PStreiffer/current-limiter-prototype/current_limiter.kicad_pcb

## KiCad design current_limiter.kicad_pcb (2026-08-11)

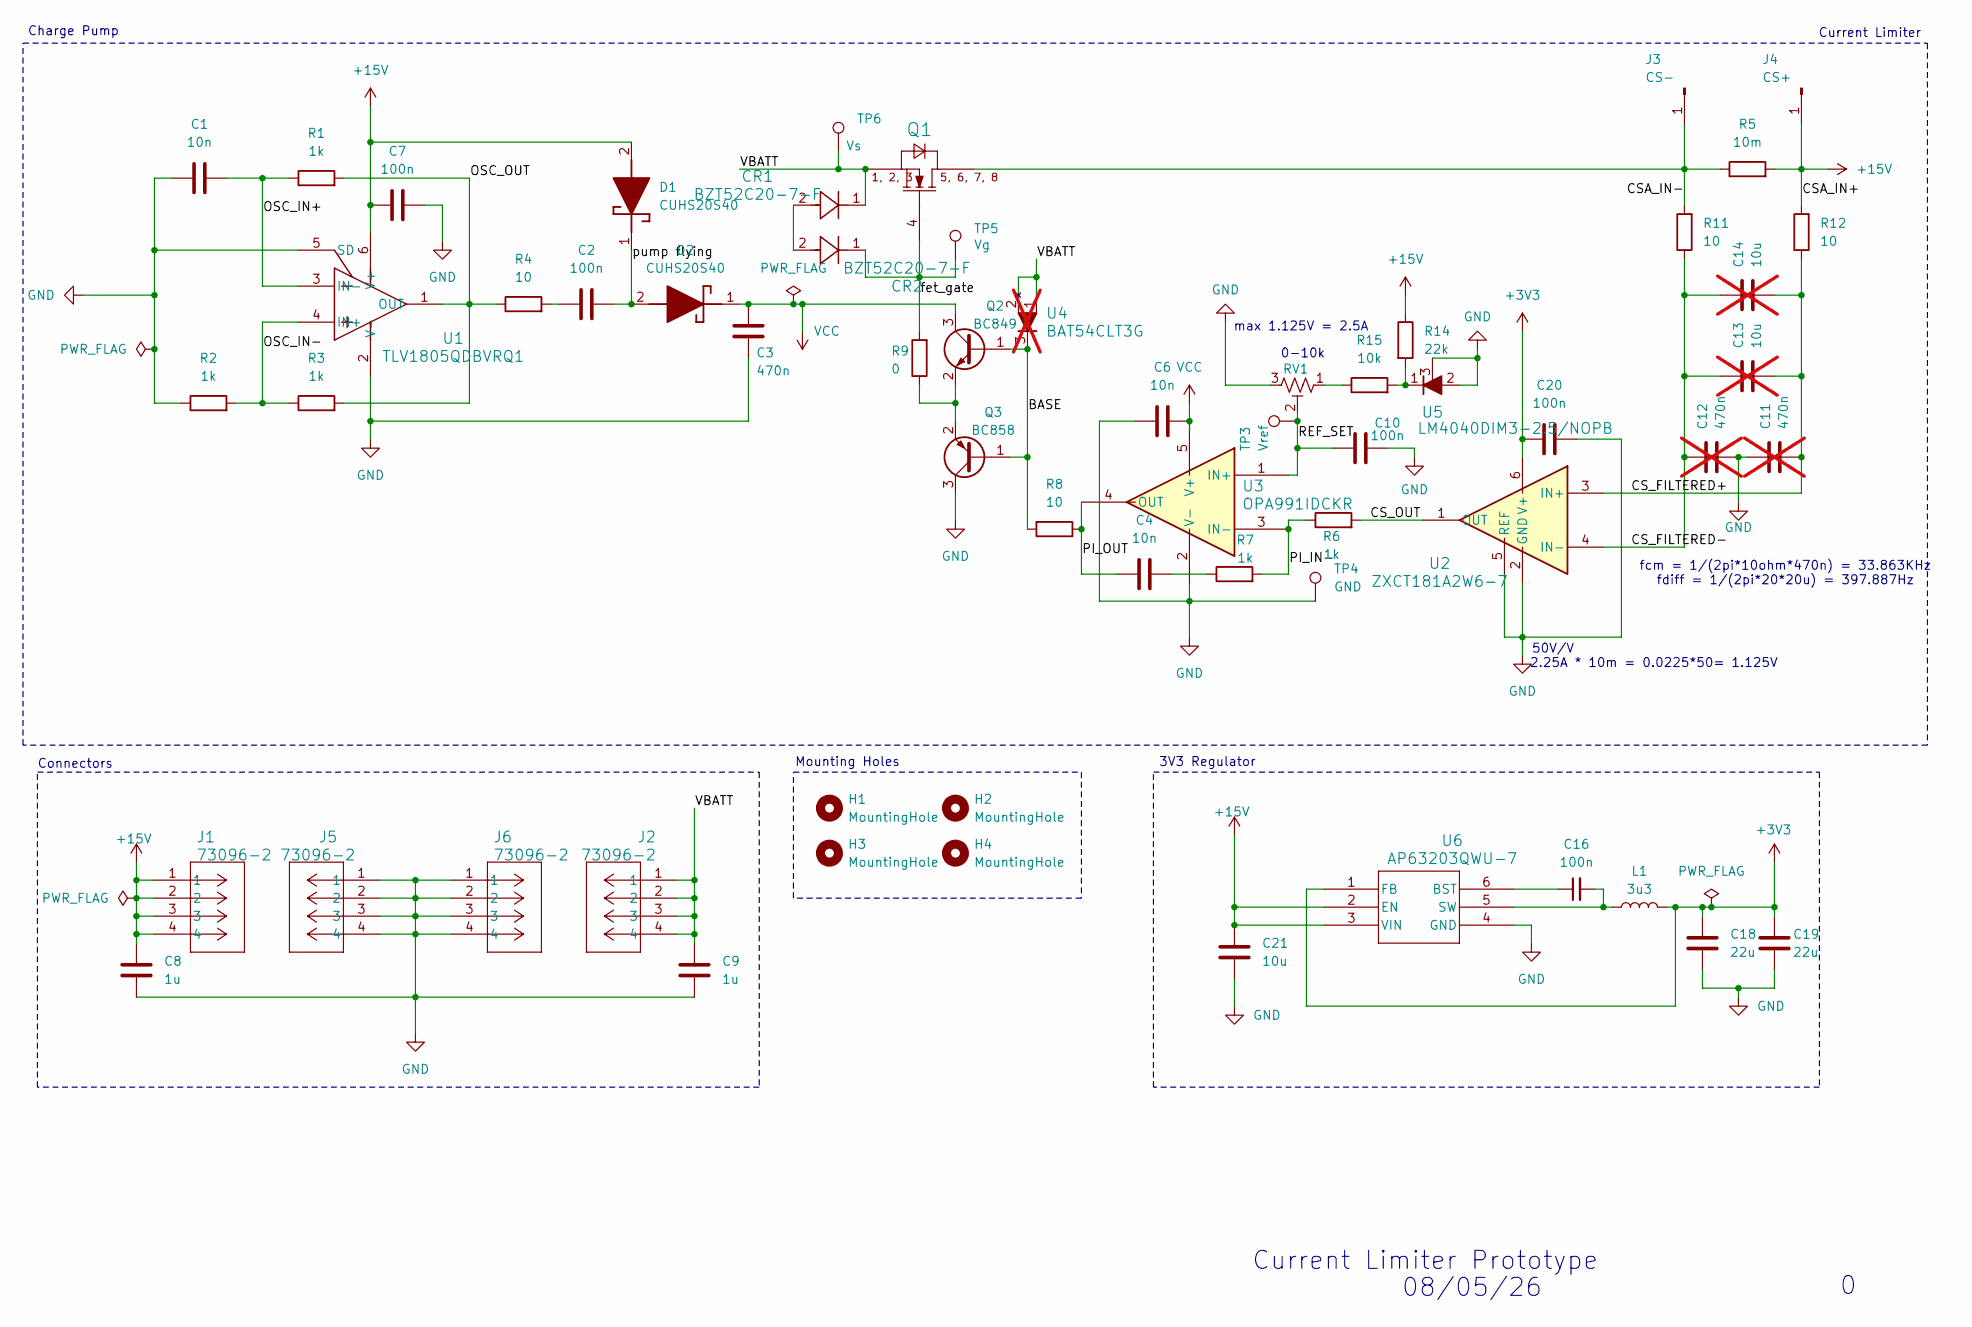
[picture p1: schematic current_limiter.kicad_sch]

Parts:
C1, C4, C6: 10n; C_0805_2012Metric
C2, C7, C10, C16, C20: 100n; C_0805_2012Metric
C3: 470n; C_0805_2012Metric
C8, C9: 1u; C_0805_2012Metric
C11, C12: 470n; C_0805_2012Metric; not fitted
C13, C14: 10u; C_0805_2012Metric; not fitted
C18, C19: 22u; C_0805_2012Metric
C21: 10u; C_0805_2012Metric
CR1, CR2: BZT52C20-7-F; SOD123_DIO
D1, D2: CUHS20S40; Manufacturer_Part_Number CUHS20S40
H1, H2, H3, H4: MountingHole; MountingHole_4.3mm_M4
J1, J2, J5, J6: 73096-2; CONN_73096-2_POM
J3: CS-; PinHeader_1x01_P1.27mm_Vertical
J4: CS+; PinHeader_1x01_P1.27mm_Vertical
L1: 3u3; IND_BOURNS_SDR0302
Q1: ISC025N08NM5LF2; INF-PG-TDSON-8-SSO8
Q2: BC849; SOT-23
Q3: BC858; SOT-23
R1, R2, R3, R6, R7: 1k; R_0805_2012Metric
R4, R8, R11, R12: 10; R_0805_2012Metric
R5: 10m; R_0805_2012Metric
R9: 0; R_0805_2012Metric
R14: 22k; R_0805_2012Metric
R15: 10k; R_0805_2012Metric
RV1: R_Potentiometer_Trim_US; Potentiometer_Runtron_RM-063_Horizontal
TP3: Vref; TestPoint_Pad_D2.0mm
TP4: GND; TestPoint_Pad_D2.0mm
TP5: Vg; TestPoint_Pad_D2.0mm
TP6: Vs; TestPoint_Pad_D2.0mm
U1: TLV1805QDBVRQ1; DBV0006A_L
U2: ZXCT181A2W6-7; DBV0006A_L
U3: OPA991IDCKR; SC_91IDCKR_TEX
U4: BAT54CLT3G; SOT-23-3_1P4X3P040_ONS; not fitted
U5: LM4040DIM3-2.5/NOPB; DBZ3
U6: AP63203QWU-7; TSOT26_DIO

Connections:
+3V3: C18.1, C19.1, C20.1, L1.2, U2.6 (V+), U6.1 (FB)
+15V: C7.1, C8.1, C21.1, D1.2 (A), J1.1, J1.2, J1.3, J1.4, J4.1 (Pin_1_1), R5.2, R12.2, R14.1, U1.6 (V+), U6.2 (EN), U6.3 (VIN)
/BASE: Q2.1 (B), Q3.1 (B), R8.2, U4.3
/CSA_IN-: J3.1 (Pin_1_1), Q1.5 (DRAIN), Q1.6 (DRAIN), Q1.7 (DRAIN), Q1.8 (DRAIN), R5.1, R11.2
/CS_FILTERED+: C11.1, C13.1, C14.1, R12.1, U2.3 (IN+)
/CS_FILTERED-: C12.2, C13.2, C14.2, R11.1, U2.4 (IN-)
/CS_OUT: R6.2, U2.1 (OUT)
/OSC_IN+: C1.2, R1.1, U1.3 (IN-)
/OSC_IN-: R2.2, R3.1, U1.4 (IN+)
/OSC_OUT: R1.2, R3.2, R4.1, U1.1 (OUT)
/PI_IN-: R6.1, R7.2, U3.3 (IN-)
/PI_OUT: C4.1, R8.1, U3.4 (OUT)
/REF_SET: C10.2, RV1.2, TP3.1 (1_1), U3.1 (IN+)
/VBATT: C9.1, CR1.1, J2.1, J2.2, J2.3, J2.4, Q1.1 (SOURCE), Q1.2 (SOURCE), Q1.3 (SOURCE), TP6.1 (1_1), U4.1, U4.2
/fet_gate: CR2.1, Q1.4 (GATE), R9.2, TP5.1 (1_1)
/pump flying: C2.2, D1.1 (K), D2.2 (A)
GND: C1.1, C3.1, C6.1, C7.2, C8.2, C9.2, C10.1, C11.2, C12.1, C18.2, C19.2, C20.2, C21.2, J5.1, J5.2, J5.3, J5.4, J6.1, J6.2, J6.3, J6.4, Q3.3 (C), R2.1, RV1.3, TP4.1 (1_1), U1.2 (V-), U1.5 (SD), U2.2 (GND), U2.5 (REF), U3.2 (V-), U5.2, U5.3, U6.4 (GND)
unnamed: C2.1, R4.2
unnamed: C4.2, R7.1
unnamed: CR1.2, CR2.2
unnamed: Q2.2 (E), Q3.2 (E), R9.1
unnamed: R14.2, R15.2, U5.1
unnamed: R15.1, RV1.1
unnamed: C16.1, U6.6 (BST)
unnamed: C16.2, L1.1, U6.5 (SW)
VCC: C3.2, C6.2, D2.1 (K), Q2.3 (C), U3.5 (V+)

Notes on the sheet:
fcm = 1/(2pi*10ohm*470n) = 33.863KHz fdiff = 1/(2pi*20*20u) = 397.887Hz
Charge Pump
Connectors
0-10k
08/05/26
max 1.125V = 2.5A
50V/V
3V3 Regulator
Current Limiter
Mounting Holes
2.25A * 10m = 0.0225*50= 1.125V
Current Limiter Prototype

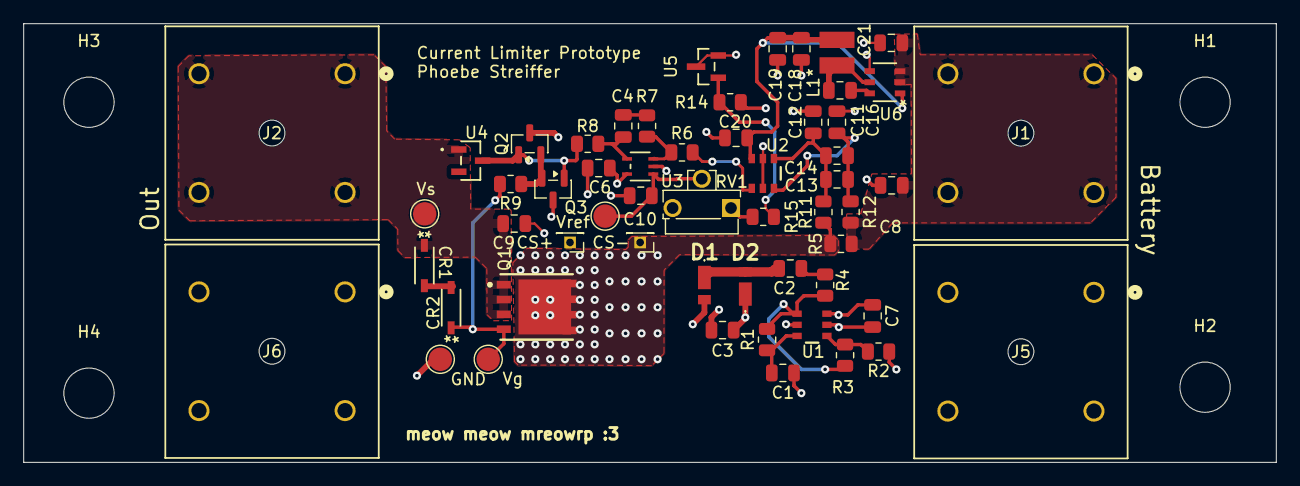
[picture p2: board current_limiter.kicad_pcb from above]

Board: 4 copper layers, 107.2 x 37.5 mm, 60 parts (0 on the bottom side), 26 nets.
