PStreiffer/current-limiter-prototype/(commit log)

2026-08-06 version 1
    [430450627.stp, 4304506yy_6.psm, BSC040N10NS5.SchLib, DBV0006A.stl, EDI2CAP.CFG, INF-PG-TDSON-8-SSO8.PcbLib, chips.prt, current_limiter.kicad_pcb]
2026-08-06 version 2: changed opamp & diodes to more responsible components, changed reference voltage
    [430450627.stp, 4304506yy_6.psm, BSC040N10NS5.SchLib, DBV0006A.stl, EDI2CAP.CFG, INF-PG-TDSON-8-SSO8.PcbLib, chips.prt, current_limiter.kicad_pcb]
2026-08-07 minor updates, moved caps around + added resistor for current limiting
    [current_limiter.kicad_pcb, current_limiter.kicad_sch]
2026-08-07 minor updates, added second zener to cap negative Vgs and DNP diode for potential minimum opamp output
    [current_limiter.kicad_pcb, current_limiter.kicad_sch]
2026-08-08 version 3: updated to 4-layer board, added shunts + various current-limiting resistors, changed reference to have maximum value of 5A
    [current_limiter.kicad_pcb, current_limiter.kicad_sch]
2026-08-08 minor revisions, changed molex to banana plug and readjusted zones
    [current_limiter.kicad_pcb, current_limiter.kicad_sch]
2026-08-08 small revisions: chamfered corners
    [current_limiter.kicad_pcb]
2026-08-09 minor revisions: added mounting holes, changed one track to back signal layer
    [current_limiter.kicad_pcb, current_limiter.kicad_sch]
2026-08-10 proper shunt setup, properly calculated resistance values necessary for shunt diode to operate safely
    [current_limiter.kicad_pcb, current_limiter.kicad_sch]
2026-08-10 minor update: changed resistor value from 20k to 22k for E12 value
    [current_limiter.kicad_pcb, current_limiter.kicad_sch]
2026-08-10 minor updates: swapped out currentsense for in stock version, made sure all parts in stock, corrected Vs for currentsense
    [current_limiter.kicad_pcb, current_limiter.kicad_sch]
2026-08-10 updated zeners to model thats actually in stock
    [current_limiter.kicad_pcb, current_limiter.kicad_sch]
2026-08-11 updated all passive components to 805 footprint, added 3V3 regulator for currentsense
    [current_limiter.kicad_pcb, current_limiter.kicad_sch]
2026-08-11 updated 3v3 reg to be correct ala datasheet
    [current_limiter.kicad_pcb, current_limiter.kicad_sch]
2026-08-11 minor changes including changing to more viable inductor footprint & correct inductor sizing
    [current_limiter.kicad_pcb, current_limiter.kicad_sch]
